Dennis-van-Gils/project-e-coli-sauna/docs/electronic_diagram.pdf

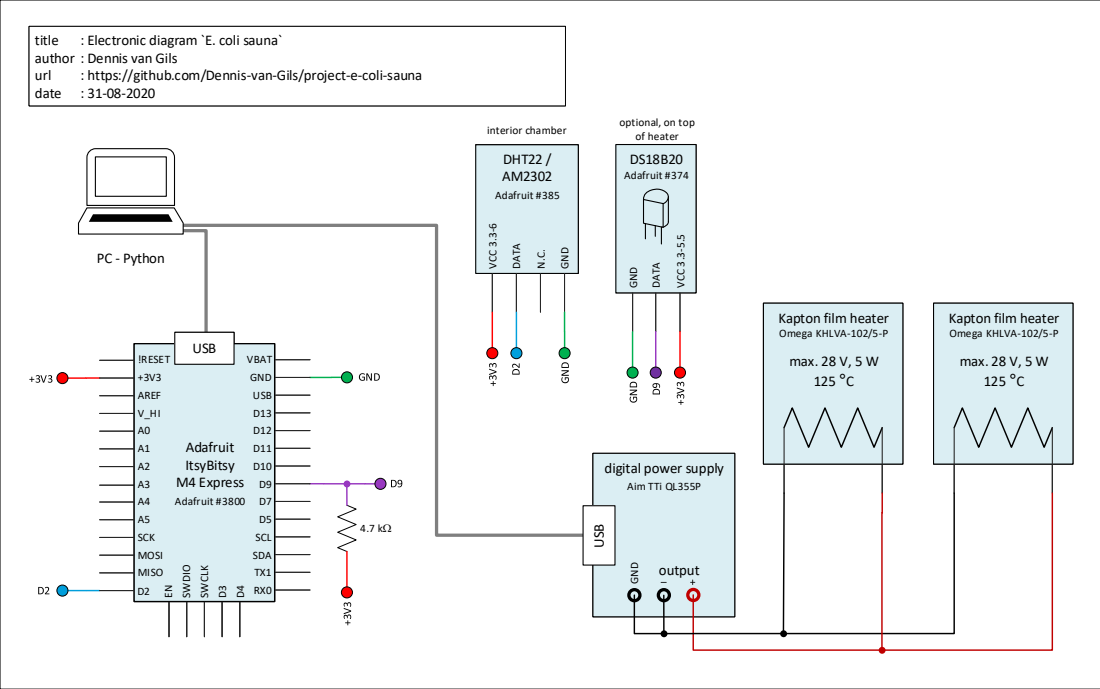
[picture p2: page 1]

author : Dennis van Gils

of heater interior chamber
