Dennis-van-Gils/project-e-coli-sauna/CHANGELOG.rst

Changelog
=========

1.0.0 (2020-08-31)
------------------
* Initial release
