Dennis-van-Gils/project-e-coli-sauna/(commit log)

2020-08-31 PID tuning
2020-08-31 PID tuned and ready for v1.0
2021-12-04 Add explicit dependency on `dvg-pid-controller`
