Dennis-van-Gils/project-e-coli-sauna/(notices)

Notices in the files:
README.rst:
.. image:: https://img.shields.io/badge/License-MIT-purple.svg
